pitschu/Ambilight-STM32F4-GNUARM-V1.2/Documents/Ambilight-discovery_bachp_V1.2.brd

## EAGLE design Documents/Ambilight-discovery_bachp_V1.2.brd (2014-07-25)

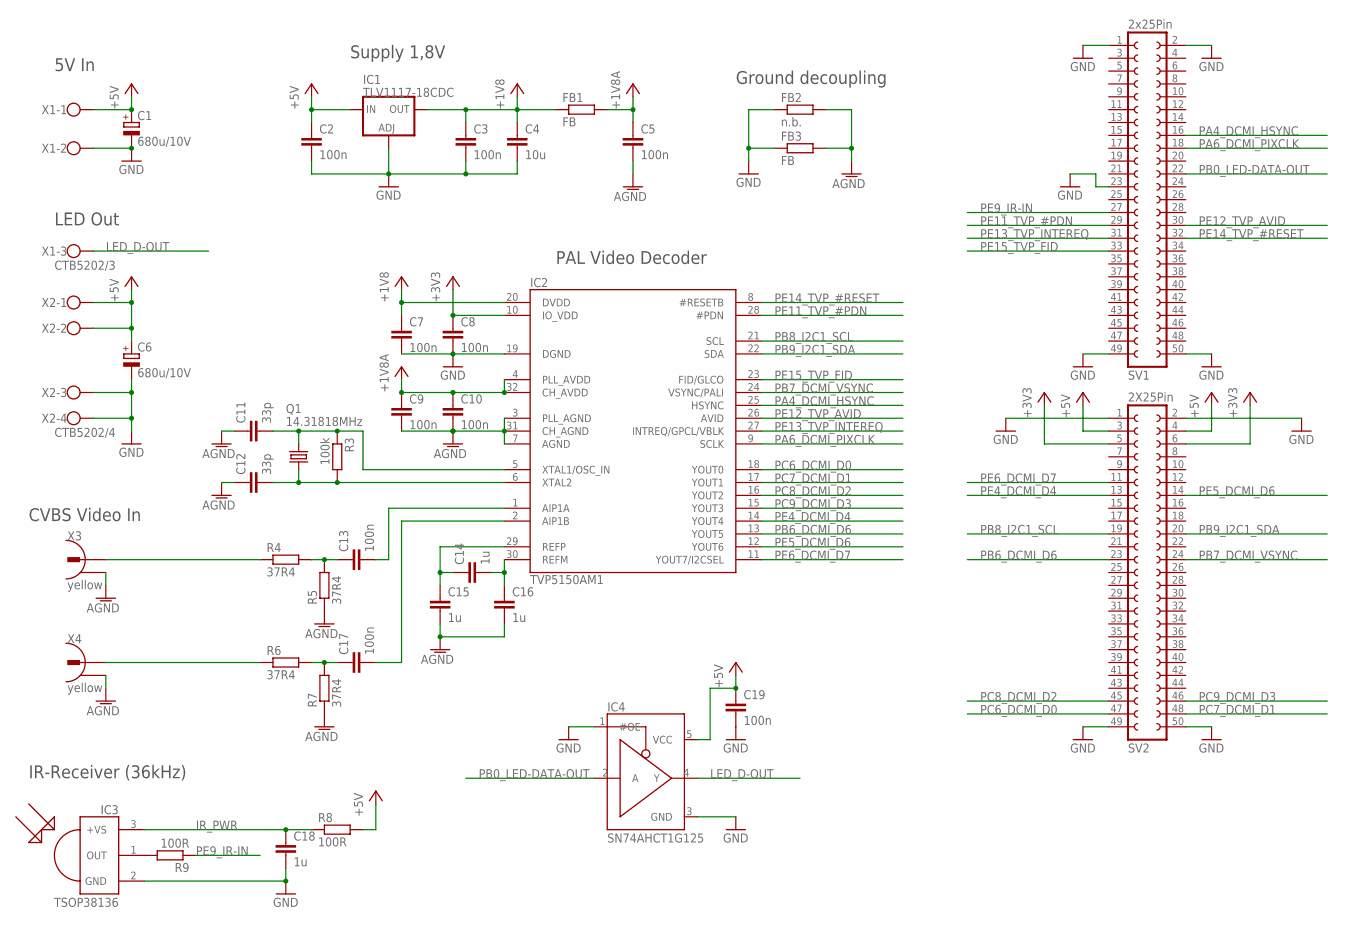
[picture p1: schematic Ambilight-discovery_bachp_V1.2.sch]

Parts:
C1, C6: 680u/10V; 153CLV-1012
C2, C3, C5, C7, C8, C9, C10, C13, C17, C19: 100n; C0805
C4: 10u; C1210
C11, C12: 33p; C0805
C14, C15, C16, C18: 1u; C0805
FB1, FB3: FB; R0805
FB2: n.b.; R0805
IC1: TLV1117-18CDC; SOT223
IC2: TVP5150AM1; TQFP32-0.5MM
IC3: TSOP38136; TSOP38XXX
IC4: SN74AHCT1G125; SOT23-5L
Q1: 14.31818MHz; HC49UP
R3: 100k; R0805
R4, R5, R6, R7: 37R4; R0805
R8, R9: 100R; R0805
SV1: 2x25Pin; FE25-2
SV2: 2X25Pin; FE25-2
X1: CTB5202/3; W237-103
X2: CTB5202/4; W237-4
X3, X4: yellow; CINCH_JALCO

Connections:
+1V8: C3.1, C4.1, C7.1, FB1.1, IC1.2 (OUT), IC1.4 (OUT), IC2.20 (DVDD)
+1V8A: C5.1, C9.1, C10.1, FB1.2, IC2.4 (PLL_AVDD), IC2.32 (CH_AVDD)
+3V3: C8.1, IC2.10 (IO_VDD), SV2.5, SV2.6
+5V: C1.+, C2.1, C6.+, C19.1, IC1.3 (IN), IC4.5 (VCC), R8.2, SV2.3, SV2.4, X1.1, X2.1, X2.2
AGND: C5.2, C9.2, C10.2, C11.1, C12.1, C15.2, C16.2, FB2.2, FB3.2, IC2.3 (PLL_AGND), IC2.7 (AGND), IC2.31 (CH_AGND), R5.1, R7.1, X3.2, X4.2
GND: C1.-, C2.2, C3.2, C4.2, C6.-, C7.2, C8.2, C18.2, C19.2, FB2.1, FB3.1, IC1.1 (ADJ), IC2.19 (DGND), IC3.2 (GND), IC4.1 (#OE), IC4.3 (GND), SV1.1, SV1.2, SV1.23, SV1.49, SV1.50, SV2.1, SV2.2, SV2.49, SV2.50, X1.2, X2.3, X2.4
IR_PWR: C18.1, IC3.3 (+VS), R8.1
LED_D-OUT: IC4.4 (Y), X1.3
unnamed: C14.1, C15.1, IC2.29 (REFP)
unnamed: C14.2, C16.1, IC2.30 (REFM)
unnamed: C17.1, R6.2, R7.2
unnamed: C17.2, IC2.2 (AIP1B)
unnamed: C13.2, IC2.1 (AIP1A)
unnamed: C13.1, R4.2, R5.2
unnamed: R4.1, X3.1
unnamed: C11.2, IC2.5 (XTAL1/OSC_IN), Q1.1, R3.1
unnamed: C12.2, IC2.6 (XTAL2), Q1.2, R3.2
unnamed: R6.1, X4.1
unnamed: IC3.1 (OUT), R9.2
PA4_DCMI_HSYNC: IC2.25 (HSYNC), SV1.16
PA6_DCMI_PIXCLK: IC2.9 (SCLK), SV1.18
PB0_LED-DATA-OUT: IC4.2 (A), SV1.22
PB6_DCMI_D6: IC2.13 (YOUT5), SV2.23
PB7_DCMI_VSYNC: IC2.24 (VSYNC/PALI), SV2.24
PB8_I2C1_SCL: IC2.21 (SCL), SV2.19
PB9_I2C1_SDA: IC2.22 (SDA), SV2.20
PC6_DCMI_D0: IC2.18 (YOUT0), SV2.47
PC7_DCMI_D1: IC2.17 (YOUT1), SV2.48
PC8_DCMI_D2: IC2.16 (YOUT2), SV2.45
PC9_DCMI_D3: IC2.15 (YOUT3), SV2.46
PE4_DCMI_D4: IC2.14 (YOUT4), SV2.13
PE5_DCMI_D6: IC2.12 (YOUT6), SV2.14
PE6_DCMI_D7: IC2.11 (YOUT7/I2CSEL), SV2.11
PE9_IR-IN: R9.1, SV1.27
PE11_TVP_#PDN: IC2.28 (#PDN), SV1.29
PE12_TVP_AVID: IC2.26 (AVID), SV1.30
PE13_TVP_INTEREQ: IC2.27 (INTREQ/GPCL/VBLK), SV1.31
PE14_TVP_#RESET: IC2.8 (#RESETB), SV1.32
PE15_TVP_FID: IC2.23 (FID/GLCO), SV1.33

Notes on the sheet:
5V In
LED Out
Supply 1,8V
Ground decoupling
CVBS Video In
PAL Video Decoder
IR-Receiver (36kHz)

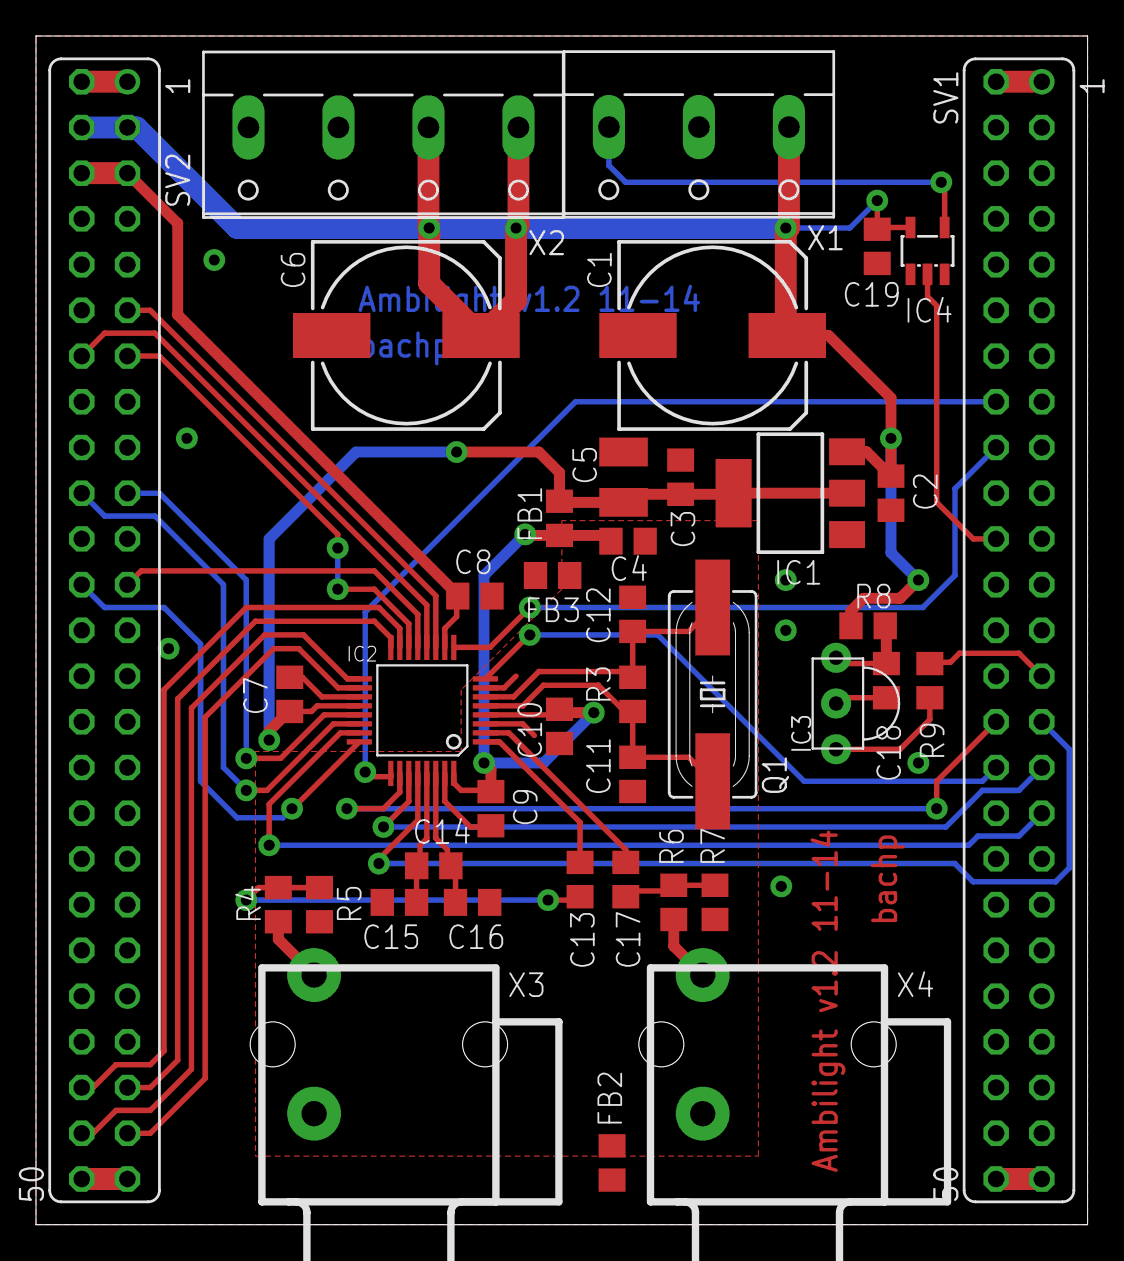
[picture p2: board Ambilight-discovery_bachp_V1.2.brd from above]

Board: 2 copper layers, 58.4 x 66.0 mm, 40 parts (0 on the bottom side), 39 nets.
