pitschu/Ambilight-STM32F4-GNUARM-V1.2/userinterface.c

/*****************************************************
 *
 *	Control program for the PitSchuLight TV-Backlight
 *	(c) Peter Schulten, Mülheim, Germany
 *	peter_(at)_pitschu.de
 *
 *	Die unveränderte Wiedergabe und Verteilung dieses gesamten Sourcecodes
 *	in beliebiger Form ist gestattet, sofern obiger Hinweis erhalten bleibt.
 *
 * 	Ich stelle diesen Sourcecode kostenlos zur Verfügung und biete daher weder
 *	Support an noch garantiere ich für seine Funktionsfähigkeit. Außerdem
 *	übernehme ich keine Haftung für die Folgen seiner Nutzung.

 *	Der Sourcecode darf nur zu privaten Zwecken verwendet und modifiziert werden.
 *	Darüber hinaus gehende Verwendung bedarf meiner Zustimmung.
 *
 *	History
 *	09.06.2013	pitschu		Start of work
 *	19.11.2013	pitschu 	first release
 *	05.05.2014	pitschu		support for: AGC control, X/Y LED size
 */

#include "stm32f4xx.h"
#include <stdio.h>
#include "string.h"
#include "main.h"
#include "ambiLight.h"
#include "stm32_ub_usb_cdc.h"


typedef enum {
	MS_NONE		= 0,
	MS_FARBTON,
	MS_CONTRAST,
	MS_BRIGHTNESS,
	MS_SATURATION,
	MS_TOP,
	MS_LEFT,
	MS_RIGHT,
	MS_HEIGHT,
	MS_ICONTROL,
	MS_IMAGE_WID,
	MS_IMAGE_HIG,
	MS_VIDEO_SRC,
	MS_FRAME_WID,
	MS_FRAME_DELAY,
	MS_TVP_AGC,			// pitschu: added 140505
	MS_XLEDS,			// pitschu: added 140502
	MS_YLEDS,
	MS_DYN_INT			// pitschu v1.2
} mainStates_e;


mainStates_e mainState = MS_NONE;


int UserInterface (void)
{
	int16_t c;

	c = get_cHost();

	if (c > 0)				// got char from user
	{
		switch (c)
		{
		case 'Q':
		case 'q':
			ambiLightPrintDynInfos();
			break;
		case 'n':
		case 'N':
			TVP5150stopCapture ();
			TVP5150init();
			TVP5150startCapture();
			break;
		case 'a':
		case 'A':
			mainState = MS_TVP_AGC;
			printf("\nAGC setting is %s\n", tvp5150AGC ? "ON" : "OFF");
			break;
		case 'm':
		case 'M':
			mainState = MS_FRAME_DELAY;
			printf("\nCurrent frame delay is %d frames\n", (int)tvprocDelayTime);
			break;
		case 'e':
		case 'E':
			mainState = MS_FRAME_WID;
			printf("\nCurrent frame width (slots) is %d\n", frameWidth);
			break;
		case 'f':
		case 'F':
			mainState = MS_FARBTON;
			printf("\nCurrent Hue control is %d\n", Hue_control);
			break;
		case 's':
		case 'S':
			mainState = MS_SATURATION;
			printf("\nCurrent Color_saturation is %d\n", Color_saturation);
			break;
		case 'b':
		case 'B':
			mainState = MS_BRIGHTNESS;
			printf("\nCurrent Brightness is %d\n", Brightness);
			break;
		case 'c':
		case 'C':
			mainState = MS_CONTRAST;
			printf("\nContrast Contrast is %d\n", Contrast);
			break;

		case 'l':
		case 'L':
			mainState = MS_LEFT;
			printf("\nCrop left is %d\n", (int)cropLeft/2);
			printf("Capture width is %d\n", (int)captureWidth);
			printf("Capture right is %d\n", (int)(cropLeft/2 + captureWidth));
			break;
		case 'w':
		case 'W':
			mainState = MS_RIGHT;
			printf("\nCrop left is %d\n", (int)cropLeft/2);
			printf("Capture width is %d\n", (int)captureWidth);
			printf("Capture right is %d\n", (int)(cropLeft/2 + captureWidth));
			break;
		case 't':
		case 'T':
			mainState = MS_TOP;
			printf("\nCrop top is %d\n", (int)cropTop);
			printf("Crop bottom is %d\n", (int)(cropTop+cropHeight-1));
			break;
		case 'h':
		case 'H':
			mainState = MS_HEIGHT;
			printf("\nCrop top is %d\n", (int)cropTop);
			printf("Crop bottom is %d\n", (int)(cropTop+cropHeight-1));
			break;

		case 'i':
		case 'I':
			mainState = MS_ICONTROL;
			printf("\nI-Control is %d\n", (int)factorI);
			break;

		case 'x':
		case 'X':
			mainState = MS_IMAGE_WID;
			printf("\nImage width in blocks is %d\n", (int)rgbImageWid);
			break;

		case 'y':
		case 'Y':
			mainState = MS_IMAGE_HIG;
			printf("\nImage height in blocks is %d\n", (int)rgbImageHigh);
			break;

		case 'v':
		case 'V':
			mainState = MS_VIDEO_SRC;
			printf("\nCurrent video source is %d, mode = %d\n", (int)videoCurrentSource, (int)videoSourceSelect);
			break;

		case 'p':
		case 'P':
			mainState = MS_XLEDS;
			printf("\nPhysical LEDS width %d\n", (int)ledsX);
			break;

		case 'r':
		case 'R':
			mainState = MS_YLEDS;
			printf("\nPhysical LEDS height %d\n", (int)ledsY);
			break;

		case 'g':
		case 'G':
			mainState = MS_DYN_INT;
			printf("\nFrames for dynamic 'black border' detection (0=OFF) %d\n", (int)dynFramesLimit);
			break;

		case '+':
		case '-':
		case 'd':
			switch (mainState)
			{
			case MS_TVP_AGC:
				if (c=='+') tvp5150AGC = 1;
				if (c=='-') tvp5150AGC = 0;
				if (c=='d')	// toggle
					tvp5150AGC  = (tvp5150AGC ? 0 : 1);		// toggle AGC
				printf("\nAGC setting is %s\n", tvp5150AGC ? "ON" : "OFF");
				break;
			case MS_FRAME_DELAY:
				if (c=='+' && tvprocDelayTime < DELAY_LINE_SIZE-1) tvprocDelayTime += 1;
				if (c=='-' && tvprocDelayTime > 0) tvprocDelayTime -= 1;
				if (c=='d')	tvprocDelayTime = 0;
				printf("Frame delay is %d frames\n", tvprocDelayTime);
				break;
			case MS_FRAME_WID:
				if (c=='+' && frameWidth < 11) frameWidth += 1;
				if (c=='-' && frameWidth > 1) frameWidth -= 1;
				if (c=='d')	frameWidth = 4;
				printf("Frame width (slots) is %d\n", frameWidth);
				break;
			case MS_FARBTON:
				if (c=='+' && Hue_control < 125) Hue_control += 1;
				if (c=='-' && Hue_control > -127) Hue_control -= 1;
				if (c=='d')	Hue_control = 0;
				printf("Hue control is %d\n", Hue_control);
				break;
			case MS_BRIGHTNESS:
				if (c=='+' && Brightness < 255) Brightness += 1;
				if (c=='-' && Brightness > 1) Brightness -= 1;
				if (c=='d')	Brightness = 60;
				printf("Brightness is %d\n", Brightness);
				break;
			case MS_SATURATION:
				if (c=='+' && Color_saturation < 255) Color_saturation += 1;
				if (c=='-' && Color_saturation > 1) Color_saturation -= 1;
				if (c=='d')	Color_saturation = 128;
				printf("Color_saturation is %d\n", Color_saturation);
				break;
			case MS_CONTRAST:
				if (c=='+' && Contrast < 197) Contrast += 1;
				if (c=='-' && Contrast > 1) Contrast -= 1;
				if (c=='d')	Contrast = 80;
				printf("Contrast is %d\n", Contrast);
				break;

			case MS_ICONTROL:
				if (c=='+' && factorI < MAX_ICONTROL) factorI += 1;
				if (c=='-' && factorI > 1) factorI -= 1;
				if (c=='d')	factorI = 32;
				printf("I-Control is %d\n", factorI);
				break;

			case MS_IMAGE_WID:
				if (c=='+' && rgbImageWid < SLOTS_X) rgbImageWid += 1;
				if (c=='-' && rgbImageWid > 1) rgbImageWid -= 1;
				if (c=='d')	rgbImageWid = SLOTS_X;
				printf("Image width in blocks is %d\n", rgbImageWid);
				ambiLightClearImage();
				break;

			case MS_IMAGE_HIG:
				if (c=='+' && rgbImageHigh < SLOTS_Y) rgbImageHigh += 1;
				if (c=='-' && rgbImageHigh > 1) rgbImageHigh -= 1;
				if (c=='d')	rgbImageHigh = SLOTS_Y;
				printf("Image height in blocks is %d\n", rgbImageHigh);
				ambiLightClearImage();
				break;

			case MS_XLEDS:
				if (c=='+' && ledsX < LEDS_XMAX) ledsX += 1;
				if (c=='-' && ledsX > 1) ledsX -= 1;
				if (c=='d')	ledsX = 48;
				ambiLightClearImage();
				printf("Physical image width (# of LEDs) is %d\n", ledsX);
				break;

			case MS_YLEDS:
				if (c=='+' && ledsY < LEDS_YMAX) ledsY += 1;
				if (c=='-' && ledsY > 1) ledsY -= 1;
				if (c=='d')	ledsY = 28;
				ambiLightClearImage();
				printf("Physical image height (# of LEDs) is %d\n", ledsY);
				break;

			case MS_LEFT:
				if (c=='+' && cropLeft/2 < 200)
				{
					cropLeft += 8;		// = 4 pixels
				}
				if (c=='-' && cropLeft/2 > 40)
				{
					cropLeft -= 8;
				}
				if (c=='d')
				{
					cropLeft = 160;
				}
				printf("\nCrop left is %d\n", (int)cropLeft/2);
				printf("Capture width is %d\n", (int)captureWidth);
				printf("Capture right is %d\n", (int)(cropLeft/2 + captureWidth));
				memset((void*)&rgbSlots[0][0], 0, sizeof (rgbSlots));
				break;
			case MS_RIGHT:
				if (c=='+' && captureWidth < 740)
				{
					captureWidth += 4;
				}
				if (c=='-' && captureWidth > 200)
				{
					captureWidth -= 4;
				}
				if (c=='d')
				{
					captureWidth = 696;
				}
				printf("\nCrop left is %d\n", (int)cropLeft/2);
				printf("Capture width is %d\n", (int)captureWidth);
				printf("Capture right is %d\n", (int)(cropLeft/2 + captureWidth));
				memset((void*)&rgbSlots[0][0], 0, sizeof (rgbSlots));
				break;
			case MS_TOP:
				if (c=='+' && cropTop < 150 && (cropTop + cropHeight) < 312)
				{
					cropTop += 1;
					cropHeight -= 1;
				}
				if (c=='-' && cropTop > 4)
				{
					cropTop -= 1;
					cropHeight += 1;
				}
				if (c=='d')
				{
					cropTop = 16;
					cropHeight = 288;
				}
				printf("\nCrop top is %d\n", (int)cropTop);
				printf("Crop bottom is %d\n", (int)(cropTop+cropHeight-1));
				memset((void*)&rgbSlots[0][0], 0, sizeof (rgbSlots));
				break;
			case MS_HEIGHT:
				if (c=='+' && (cropTop + cropHeight) < 312)
				{
					cropHeight += 1;
				}
				if (c=='-' && cropHeight > 40)
				{
					cropHeight -= 1;
				}
				if (c=='d')	cropHeight = 288;
				printf("\nCrop top is %d\n", (int)cropTop);
				printf("Crop bottom is %d\n", (int)(cropTop+cropHeight-1));
				memset((void*)&rgbSlots[0][0], 0, sizeof (rgbSlots));
				break;

			case MS_DYN_INT:
				if (c=='+' && (dynFramesLimit) < 200)
				{
					dynFramesLimit += 1;
				}
				if (c=='-' && dynFramesLimit > 0)
				{
					dynFramesLimit -= 1;
				}
				if (c=='d')	dynFramesLimit = 100;
				printf("\nFrames for dynamic 'black border' detection (0=OFF) %d\n", (int)dynFramesLimit);
				ambiLightInit ();		// flush dyn arrays
				break;

			default:
				break;
			}
			TVP5150setPictureParams();
			break;

			case '0':
			case '1':
			case '2':
				if (mainState == MS_VIDEO_SRC)
				{
					int s = c - '0';

					if (s == 0)
					{
						unsigned char i = TVP5150hasVideoSignal();

						if (i == 0 || videoSourceSelect != s)		// no signal -> switch source
						{
							TVP5150selectVideoSource(videoCurrentSource == 1 ? 2 : 1);
						}
					}
					else
					{
						TVP5150selectVideoSource(s);
					}

					videoSourceSelect = s;

					printf("\nCurrent video source is %d, mode = %d\n", (int)videoCurrentSource, (int)videoSourceSelect);
					delay_ms(1000);
					printf("    video signal state %d\n", (int)TVP5150hasVideoSignal());
					videoOffCount = 5;				// start search
				}
				break;

			default:
				printf("\nUsage: use +/- keys to set val; d=default\n");
				printf("     F=Hue, S=Saturation, B=Brightness, C=Contrast\n");
				printf("     L=Left, W=Width, T=Top, H=Height\n");
				printf("     I=I-factor of integrator (128 = MAX)\n");
				printf("     E=# of slots aggregated for LED strip (1..10)\n");
				printf("     G=Frame count for dynamic 'black border' detection (0=OFF; 1..200)\n");
				printf("     X=virtual image width in blocks\n");
				printf("     Y=virtual image height in blocks\n");
				printf("     P=Physical image width: # of LEDs\n");
				printf("     R=Physical image height: # of LEDs\n");
				printf("     V=select video source (1 or 2)\n");
				printf("     Q=show info about Dyn Matrix\n");
				printf("     N=restart TVP5150 and show reg info\n");
				printf("     A=set TVP5150 auto gain control ON/OFF\n");
				printf("     M=set frame delay time (0-20 frames)\n");
				printf("     0,1 or 2: Set input channel 1 or 2; 0 = Auto\n");
				break;
		}

		switch (mainState)
		{
		case MS_FRAME_DELAY:
			displayOverlayPercents(((int)tvprocDelayTime*100)/(DELAY_LINE_SIZE-1), 300);
			break;
		case MS_FRAME_WID:
			displayOverlayPercents(((int)frameWidth*100)/11, 300);
			break;
		case MS_FARBTON:
			displayOverlayPercents((((int)Hue_control*100)/127) + 50, 300);
			break;
		case MS_BRIGHTNESS:
			displayOverlayPercents((((int)Brightness*100)/255), 300);
			break;
		case MS_SATURATION:
			displayOverlayPercents((((int)Color_saturation*100)/255), 300);
			break;
		case MS_CONTRAST:
			displayOverlayPercents((((int)Contrast*100)/198), 300);
			break;

		case MS_ICONTROL:
			displayOverlayPercents((((int)factorI*100)/MAX_ICONTROL), 300);
			break;

		case MS_IMAGE_WID:
			displayOverlayPercents((((int)rgbImageWid*100)/SLOTS_X), 300);
			break;

		case MS_IMAGE_HIG:
			displayOverlayPercents((((int)rgbImageHigh*100)/SLOTS_Y), 300);
			break;

		case MS_LEFT:
		case MS_RIGHT:
			displayOverlayPercents(((((int)(cropLeft/2)-40)*100)/840), 300);
			displayOverlayPercents((((int)(captureWidth)*100)/840), 0);
			break;
		case MS_TOP:
			displayOverlayPercents((((int)(cropTop)*100)/150), 300);
			break;
		case MS_HEIGHT:
			displayOverlayPercents((((int)(cropHeight)*100)/300), 300);
			break;

		case MS_TVP_AGC:
			displayOverlayPercents((((int)(tvp5150AGC)*100)), 300);		// pitschu 140505
			break;
		default:
			break;
		}


	}		// if (c > 0)

	return (0);
}
