pitschu/Ambilight-STM32F4-GNUARM-V1.2/AvrXFifo.c

/*
    Buffered BYTE oriented FIFO

	Uses providers/consumer model.  When an interrupt
	drives the consumer/provider side use the interrupt calls

	The fifo needs to be both declared and initialized.
 */
#include <inttypes.h>
#include <string.h>
#include <math.h>
#include "AvrXFifo.h"

typedef uint8_t BOOL;

// Since there is only one process modifying each side of the
// FIFO, I am pretty sure critical sections are not needed.
// The only race is if the out pointer changes after the load
// and before the test. But this is not a race that will cause
// fifo corruption.

int16_t AvrXPutFifo(pAvrXFifo p, uint8_t c)
{
	short t = p->in+1;

	if (t >= p->size)
		t = 0;
	if (t == p->out)	// isFull()
	{
		return FIFO_ERR;
	}
	p->buf[p->in] = c;
	p->in = t;
	return FIFO_OK;
}



int16_t AvrXPutStringFifo(pAvrXFifo p, char *s)
{
	while (*s)
	{
		short t = p->in+1;

		if (t >= p->size)
			t = 0;
		if (t == p->out)	// isFull()
		{
			return FIFO_ERR;
		}
		p->buf[p->in] = (uint8_t)*s;
		p->in = t;

		s++;
	}
	return FIFO_OK;
}



int16_t AvrXPullFifo(pAvrXFifo p)
{
	if (p->in == p->out)	// isEmpty()
	{
		return FIFO_ERR;
	}

	uint16_t c = p->buf[p->out];
	short t = p->out+1;
	if (t >= p->size)
		t = 0;
	p->out = t;
	return c;
}



void AvrXWaitPutFifo(pAvrXFifo p, uint8_t c)
{
	while (AvrXPutFifo(p, c) == FIFO_ERR)
		;
}



int16_t AvrXWaitPullFifo(pAvrXFifo p)
{
	int16_t c;
	while ((c = AvrXPullFifo(p)) == FIFO_ERR)
		;
	return c;
	
	// debugging
}



void AvrXFlushFifo(pAvrXFifo p)
{
	p->in = 0;
	p->out = 0;
}



// Return next character to be removed (without removing it)

int16_t AvrXPeekFifo(pAvrXFifo p)
{
	if (p->in == p->out)
		return FIFO_ERR;
	else
		return p->buf[p->out];
}



// Return size of FIFO (difference between in & out

int16_t AvrXStatFifo(pAvrXFifo p)
{
	int16_t c = (uint16_t)p->in - (uint16_t)p->out;

	if (c < 0)
		c += p->size;
	return c;
}
