pitschu/Ambilight-STM32F4-GNUARM-V1.2/(commit log)

2014-05-02 Published version (mikrocontroller.net) without physical LED number setting (fixed 48*28 LEDs)
    [Bedienung.xlsx, PitschuLight V1.1.sch, PitschuLight.sch, STM32F4-DEBUG.cfg, STM32F4-FLASH.cfg]
2014-05-04 Added code for: - Support of blue button (Mode selct: Ambi/Mood/Standby) - Set physical LED count: 'P' = width; 'R' = height; MAX = 80x60 - Fixed bugs in flashparams.c - Added 'N' = Reset TVP5150 and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
    [ambiLight.c, ambiLight.h, delay.c, flashparams.c, flashparams.h, i2c1.c, main.c, moodlight.c]
2014-05-05 Added AGC on/off switch Some minor bug fixes and comments
    [Bedienung.xlsx, STM32F4-FLASH.cfg]
2014-07-25 V1.2 - fixed bugs in tvp5150:dcmi.c (SLOTs devider) - added dynFramesLimit - some default values updated - avoid black-flickering (ambiLight.c)
    [Ambilight-discovery_bachp_V1.2.brd, Ambilight-discovery_bachp_V1.2.sch, BOM_Ambilight-discovery_bachp_V1.2.xlsx, Bedienung.xlsx, STM32F4-FLASH.cfg]
2015-03-06 Updated GNU-ARM eclipse tools and toolchain 4.9.3
2015-03-06 Revert "Updated GNU-ARM eclipse tools and toolchain 4.9.3"
    This reverts commit 6c42dfe02f2de7abf1f6423b96cd0f630189174d.
    [IRdecoder.h, ambiLight.h, flashparams.h, hardware.h, main.h, moodLight.h]
2016-05-22 Updated Eagle files and documents
    [Ambilight-discovery_bachp_V1.2.brd, Ambilight-discovery_bachp_V1.2.sch, BOM_Ambilight-discovery_bachp_V1.2.xlsx, Bedienung.xlsx, PitschuLight V1.1.sch, PitschuLight.sch, STM32F4-DEBUG.cfg, STM32F4-FLASH.cfg]
